albtrentadue/NOAA_Corni2013/Kit/Turnstile/20130330_175853.jpg

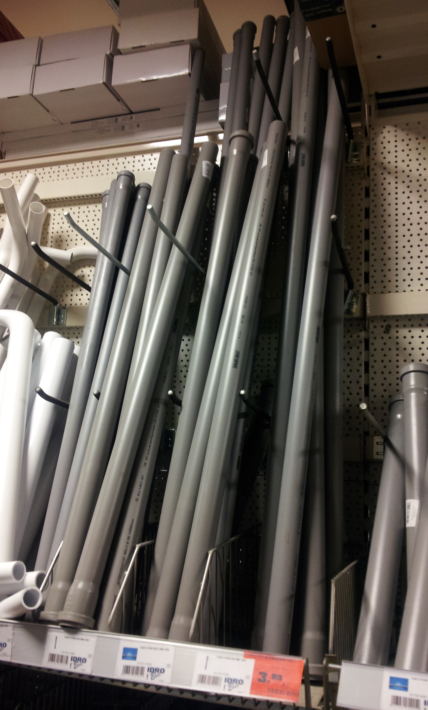
Kit/Turnstile/20130330_175853.jpg
