albtrentadue/NOAA_Corni2013/Kit/Turnstile/137MHz Turnstile Antenna for APT satellite reception » DigitalHam_files/early_turnstile.jpg

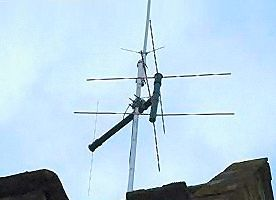
Kit/Turnstile/137MHz Turnstile Antenna for APT satellite reception » DigitalHam_files/early_turnstile.jpg
