albtrentadue/NOAA_Corni2013/Kit/SW_Download.odt

Satelliti NOAA

Link download Software:

SDR# - Programma di Software Defined radio per pilotare la il ricevitore USB RTL

http://sdrsharp.com/

Virtual Audio Cable – Scheda audio virtuale per connettere l'audio di processi indipendenti

http://software.muzychenko.net/eng/vac.htm

WxToImg – Programma di decodifica e visualizzazione delle immagini APT dei NOAA

http://www.wxtoimg.com/
