albtrentadue/NOAA_Corni2013/NOAA_RX-Arch.pdf

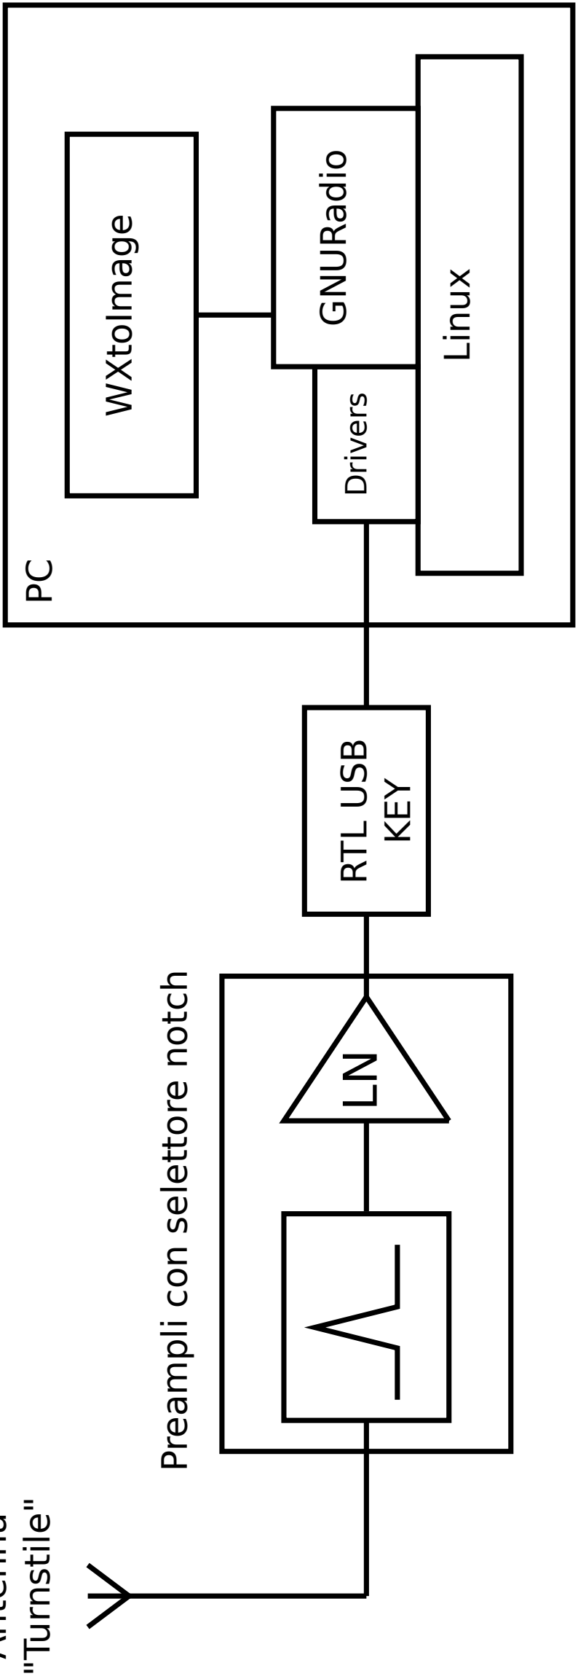
[picture p3: figure]
LN RTL USB; KEY; Linux; Drivers GNURadio; WXtoImage; Preampli con selettore notch; "Turnstile"

Antenna
