albtrentadue/NOAA_Corni2013/Kit/Turnstile/137MHz Turnstile Antenna for APT satellite reception » DigitalHam_files/circular_polarization.gif

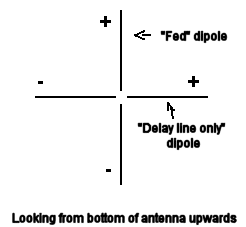
Kit/Turnstile/137MHz Turnstile Antenna for APT satellite reception » DigitalHam_files/circular_polarization.gif
