albtrentadue/NOAA_Corni2013/Kit/Turnstile/137MHz Turnstile Antenna for APT satellite reception » DigitalHam_files/turnstile_obstructed1.jpg

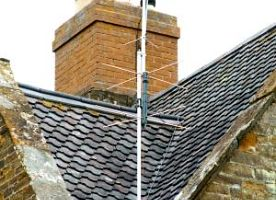
Kit/Turnstile/137MHz Turnstile Antenna for APT satellite reception » DigitalHam_files/turnstile_obstructed1.jpg
