albtrentadue/NOAA_Corni2013/Kit/Turnstile/20130330_180533.jpg

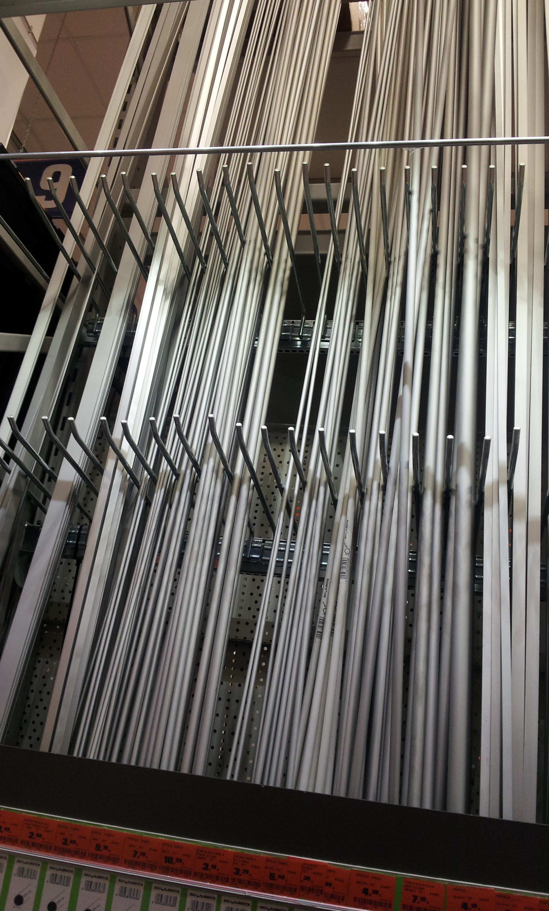
Kit/Turnstile/20130330_180533.jpg
