albtrentadue/NOAA_Corni2013/ElencoComponenti.xls

Progetto satelliti NOAA
Dispositivo | Descrizione | Q.tà |  | Costo unit. | Costo tot.
 |  |  |  |  | €290.00
Filtro pre-amplificatore (x 10)
C1 | 10pF | 10 |  | €0.20 | €2.00
C2 | 18pF | 10 |  | €0.20 | €2.00
C3 | 22pF | 10 |  | €0.20 | €2.00
C4 | 3pF | 10 |  | €0.20 | €2.00
C5 | 22pF | 10 |  | €0.20 | €2.00
C6 | 22pF | 10 |  | €0.20 | €2.00
C7 | 3pF | 10 |  | €0.20 | €2.00
C8 | 22pF | 10 |  | €0.20 | €2.00
C9 | 18pF | 10 |  | €0.20 | €2.00
C10 | 10pF | 10 |  | €0.20 | €2.00
C11 | 1nF | 10 |  | €0.20 | €2.00
C12 | 100n | 10 |  | €0.20 | €2.00
D1 | 1N4004 | 10 |  | €0.20 | €2.00
L1 | 106nH | 10 |  | €0.20 | €2.00
L2 | 110nH | 10 |  | €0.20 | €2.00
L3 | 106nH | 10 |  | €0.20 | €2.00
L4 | RFC | 10 |  | €0.50 | €5.00
L5 | RFC | 10 |  | €0.50 | €5.00
P1 | BNC | 10 |  | €1.00 | €10.00
P2 | BNC | 10 |  | €1.00 | €10.00
RV1 | 220 | 10 |  | €1.00 | €10.00
U1 | MAR6 | 10 |  | €3.00 | €30.00
U2 | 7806 | 10 |  | €1.00 | €10.00
Antenna (x 2)
Tubo diametro | diametro 40 mm | 3 | pezzi da 1 m | €2.00 | €6.00
Alluminio | diametro int. 4 mm - est. 6 mm | 9 | barre da 2m | €2.00 | €18.00
Cavo RG58 |  | 0.5 | m | €0.00 | €0.00
Teflon per supporto dipoli antenna | diametro 4 mm | 12 | barrette da 1 m | €0.50 | €6.00
Cavo TV satellite | 100 m | 1 | matassa | €20.00 | €20.00
Scatola metallica per circuito |  | 3 |  | €5.00 | €15.00
Scatola stagna di fissaggio al palo |  | 3 |  | €6.00 | €18.00
Ricevitore (x 1)
Chiavetta RTL2832 |  | 3 |  | €25.00 | €75.00
Software WXTOIMG |  | 1 |  | €20.00 | €20.00
SDR Sharp |  | 3 |  | €0.00 | €0.00
