albtrentadue/NOAA_Corni2013/Kit/Turnstile/Turnstile-rad-topview.dxf

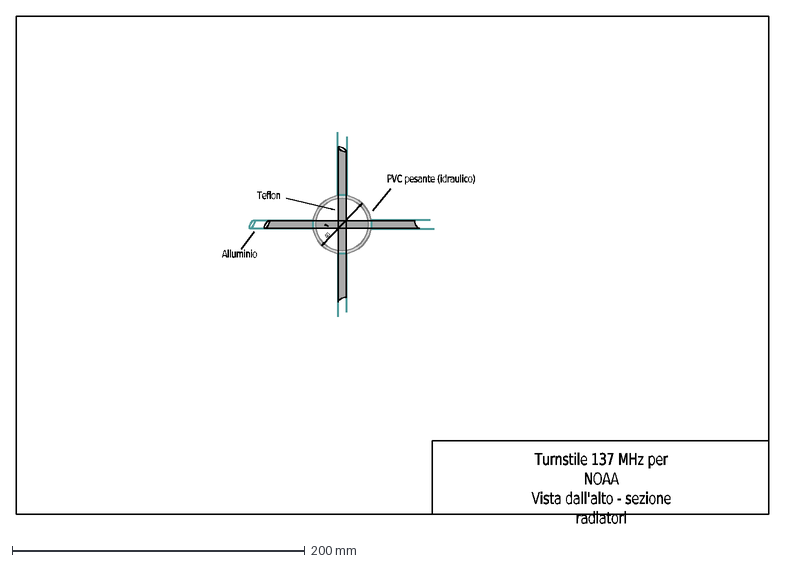
[picture p8: CAD file, 2021-03-10]
Kit/Turnstile/Turnstile-rad-topview.dxf
40
Alluminio
Teflon
Turnstile 137 MHz per NOAA Vista dall'alto - sezione radiatori
PVC pesante (idraulico)
