albtrentadue/NOAA_Corni2013/Kit/Turnstile/Turnstile-rif-topview.dxf

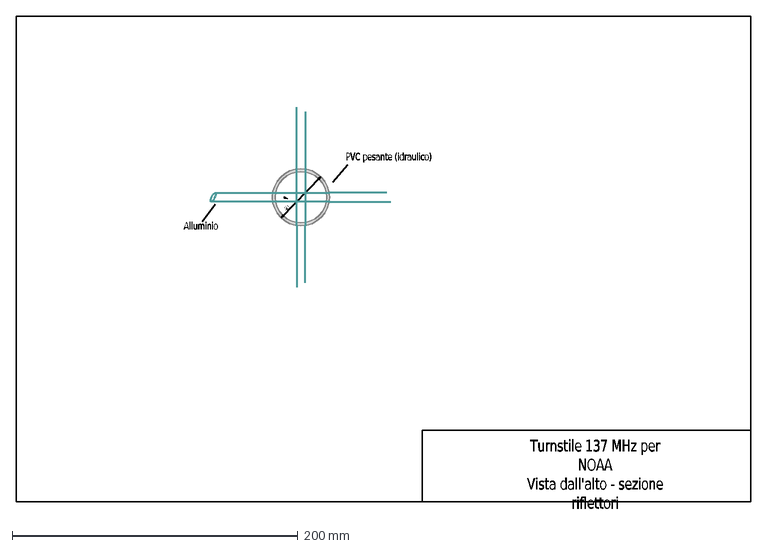
[picture p9: CAD file, 2021-03-10]
Kit/Turnstile/Turnstile-rif-topview.dxf
40
Alluminio
Turnstile 137 MHz per NOAA Vista dall'alto - sezione riflettori
PVC pesante (idraulico)
