albtrentadue/NOAA_Corni2013/Kit/Turnstile/Turnstile-frontview.dxf

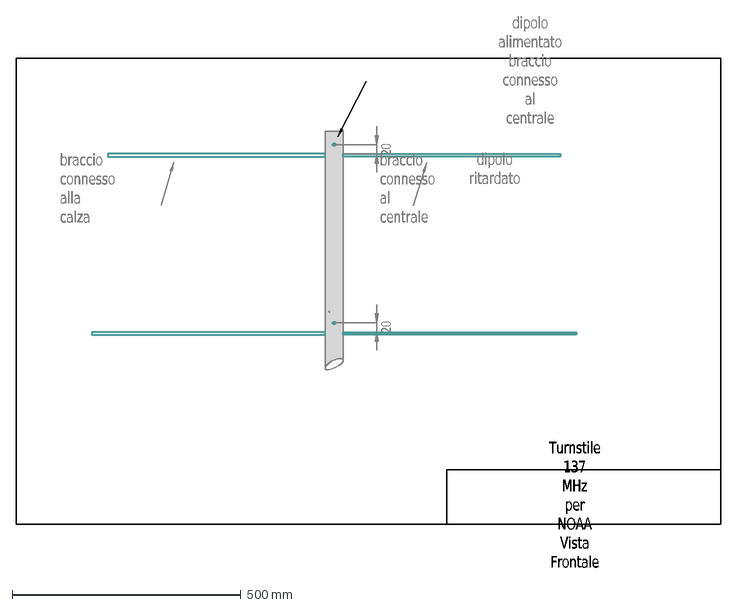
[picture p10: CAD file, 2021-03-10]
Kit/Turnstile/Turnstile-frontview.dxf
20
dipolo ritardato
braccio connesso alla calza
braccio connesso al centrale
Turnstile 137 MHz per NOAA Vista Frontale
dipolo alimentato braccio connesso al centrale
