albtrentadue/NOAA_Corni2013/Kit/Preampli/NOAA-preamp-v1.0.pdf

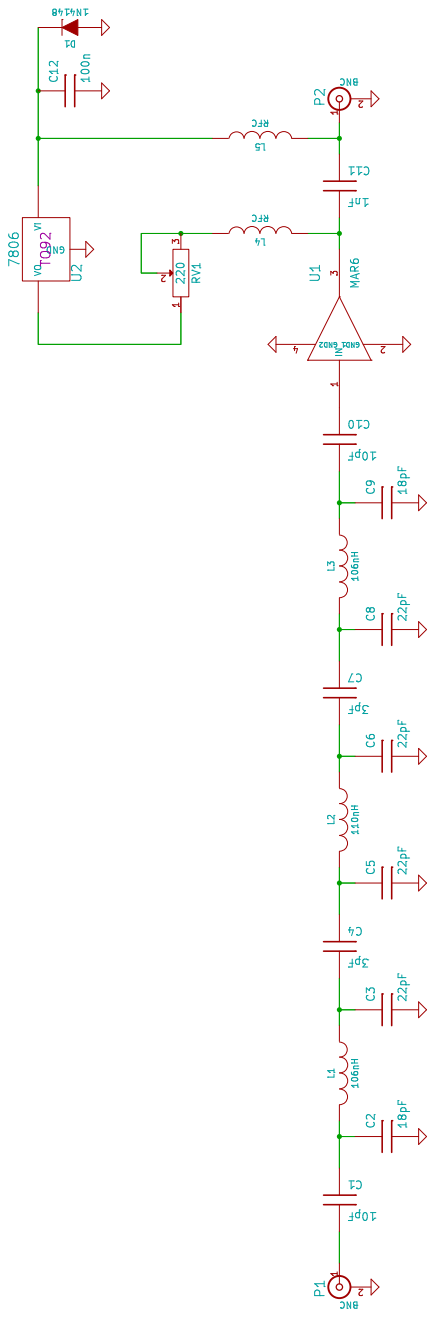
[picture p15: page 1]
