albtrentadue/NOAA_Corni2013/Kit/Turnstile/Turnstile-frontview.pdf

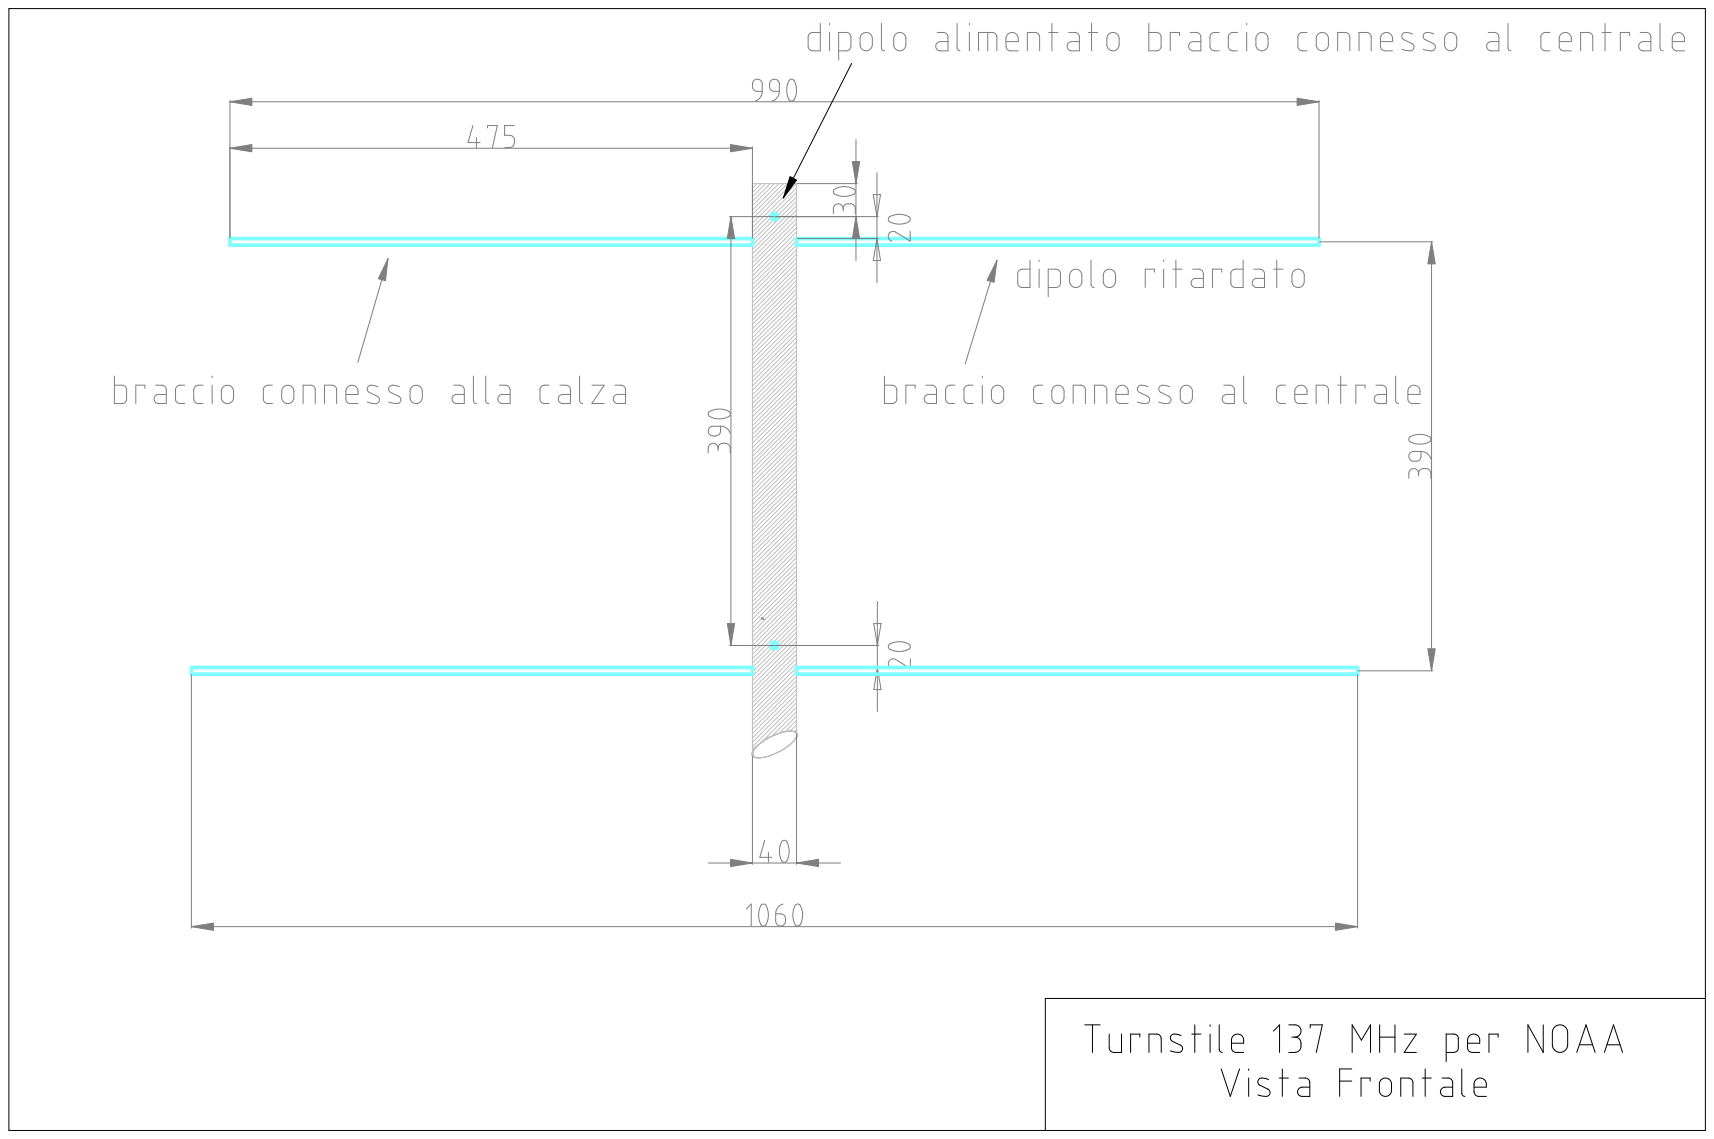
[picture p16: page 1]
