albtrentadue/NOAA_Corni2013/Kit/Turnstile/Turnstile-rad-topview.pdf

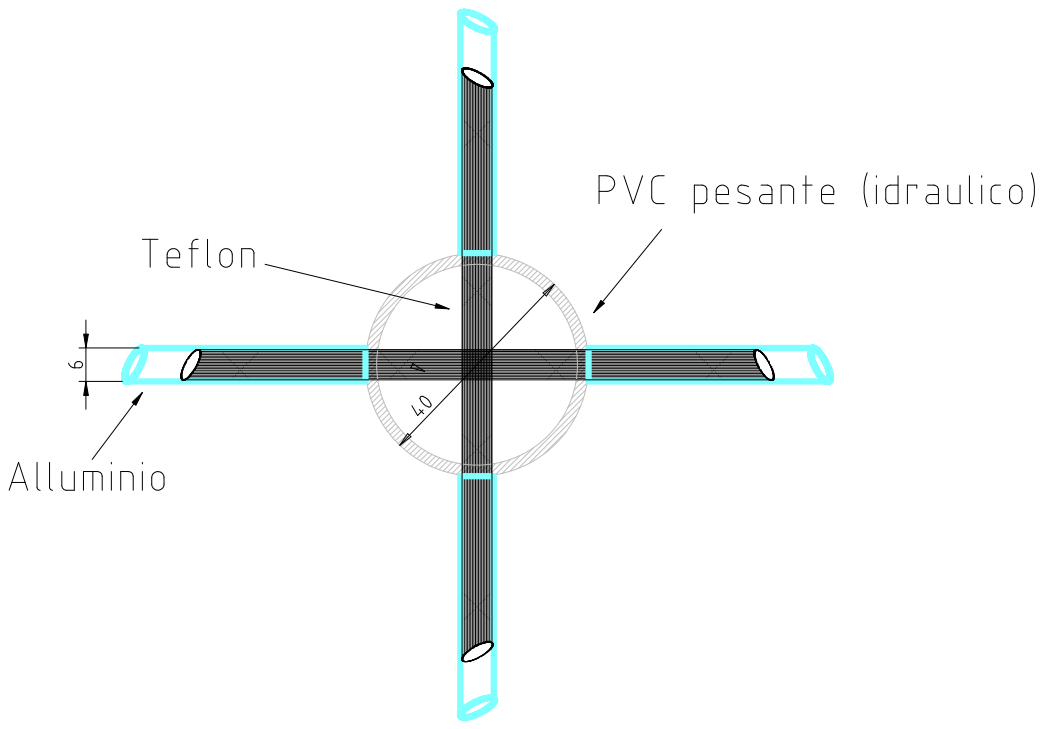
[picture p17: page 1]
