albtrentadue/NOAA_Corni2013/Kit/Turnstile/Turnstile-rif-topview.pdf

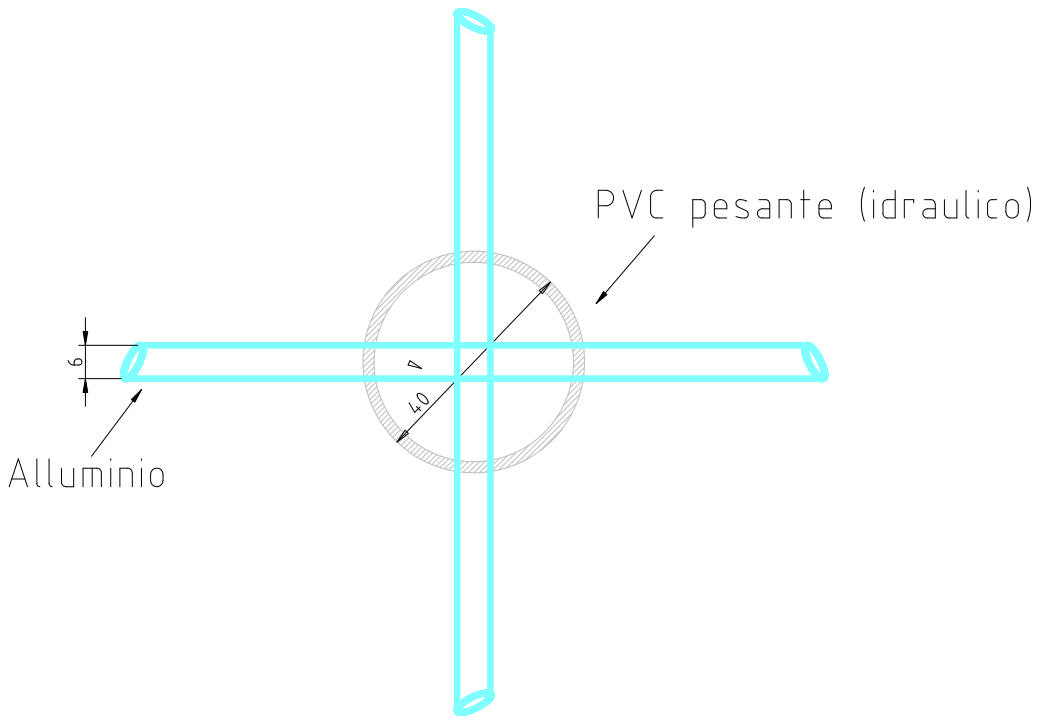
[picture p18: page 1]
